Luk13g/Absolute_Encoder_5Bits/Imagens/Img_03.jpg

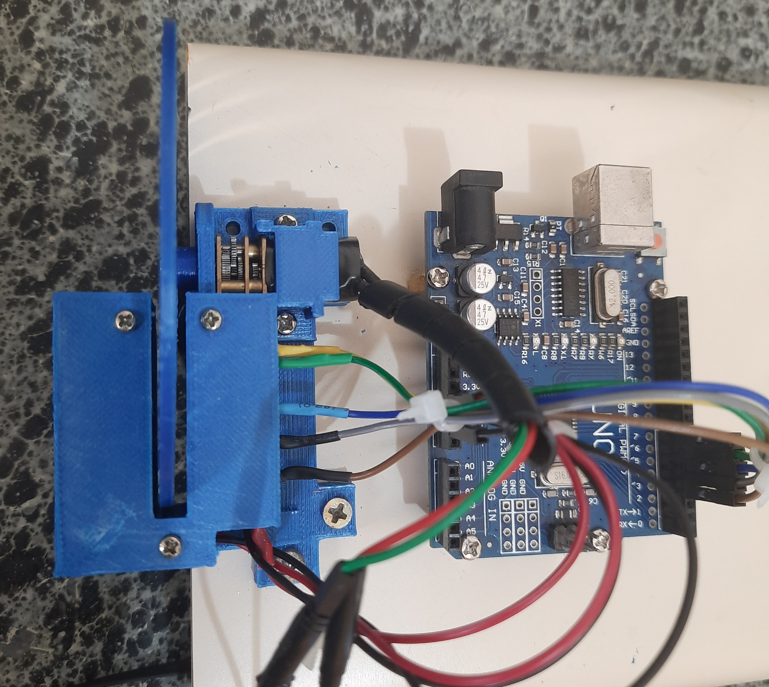
Imagens/Img_03.jpg
