Luk13g/Absolute_Encoder_5Bits/Imagens/Img_02.jpg

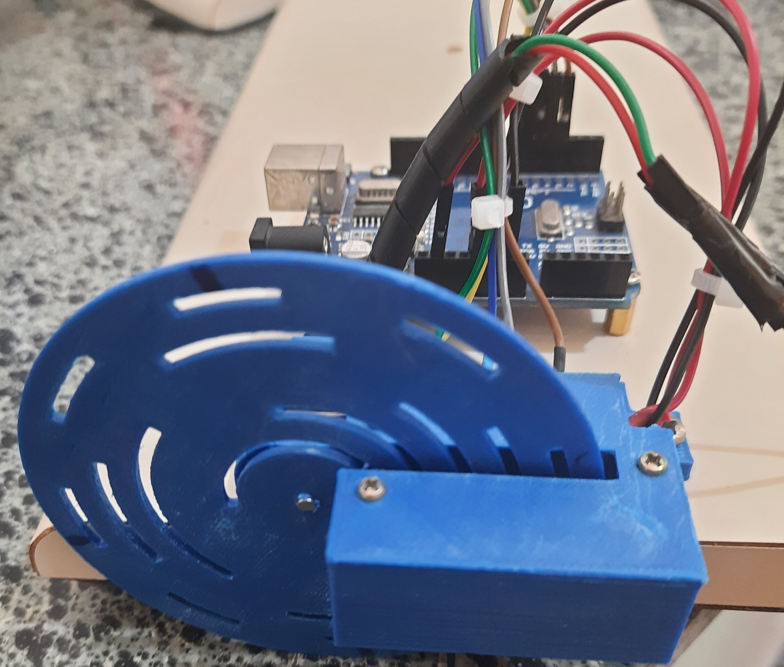
Imagens/Img_02.jpg
