Luk13g/Absolute_Encoder_5Bits/README.md

# Absolute_Encoder_5Bits
Absolute rotary encoder with 5 rows of slits
