Luk13g/Absolute_Encoder_5Bits/Imagens/Img_01.jpg

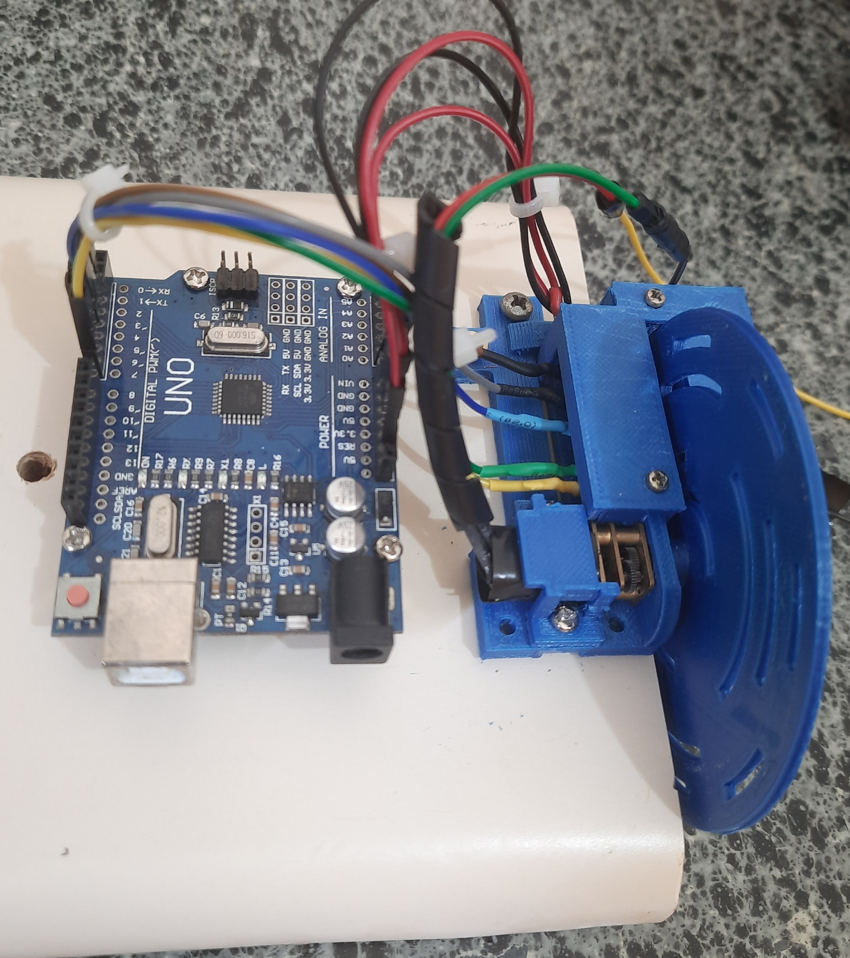
Imagens/Img_01.jpg
