Luk13g/Absolute_Encoder_5Bits/3D_parts/disco_oficial_code_gray.stl

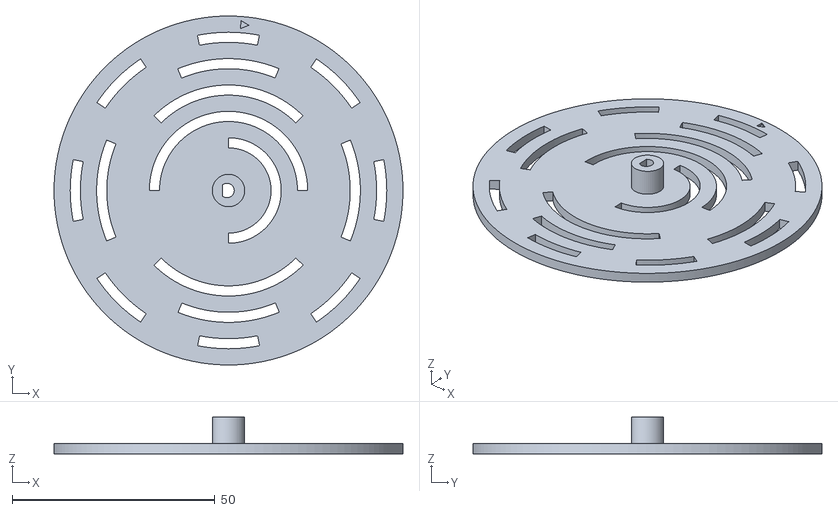
[picture p4: CAD file, 2022-12-28]
3D_parts/disco_oficial_code_gray.stl
86.0 x 86.0 x 9.00
