Luk13g/Absolute_Encoder_5Bits/3D_parts/TESTEE.stl

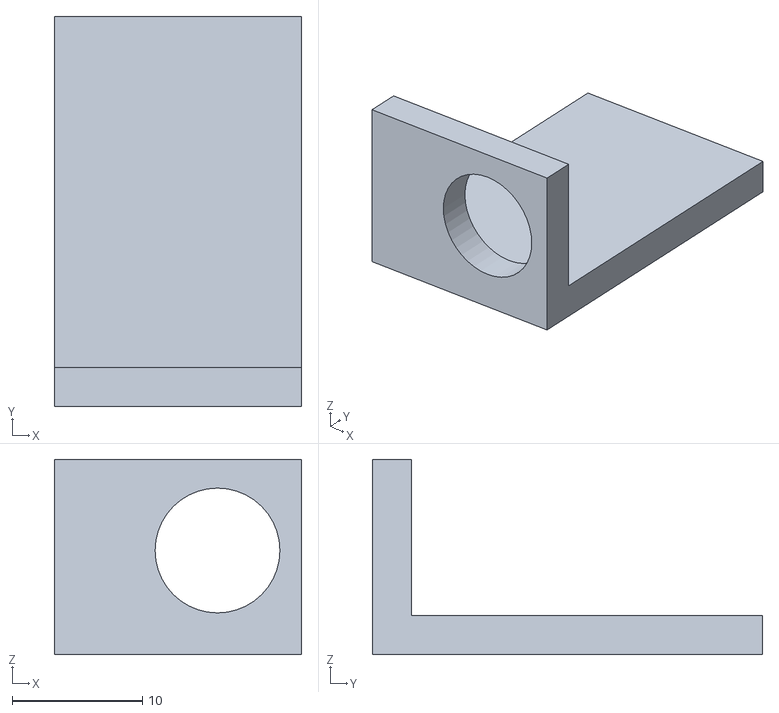
[picture p5: CAD file, 2022-12-28]
3D_parts/TESTEE.stl
19.0 x 30.0 x 15.0
