Luk13g/Absolute_Encoder_5Bits/3D_parts/suporte_sensores2.stl

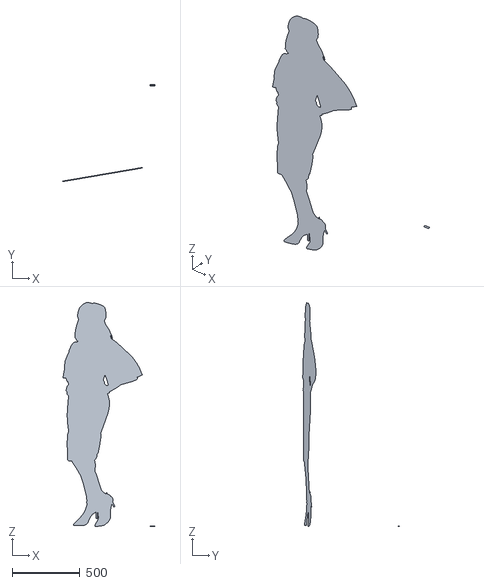
[picture p6: CAD file, 2022-12-28]
3D_parts/suporte_sensores2.stl
680.1 x 712.3 x 1649.7
