Luk13g/Absolute_Encoder_5Bits/3D_parts/4_teste_pecas.stl

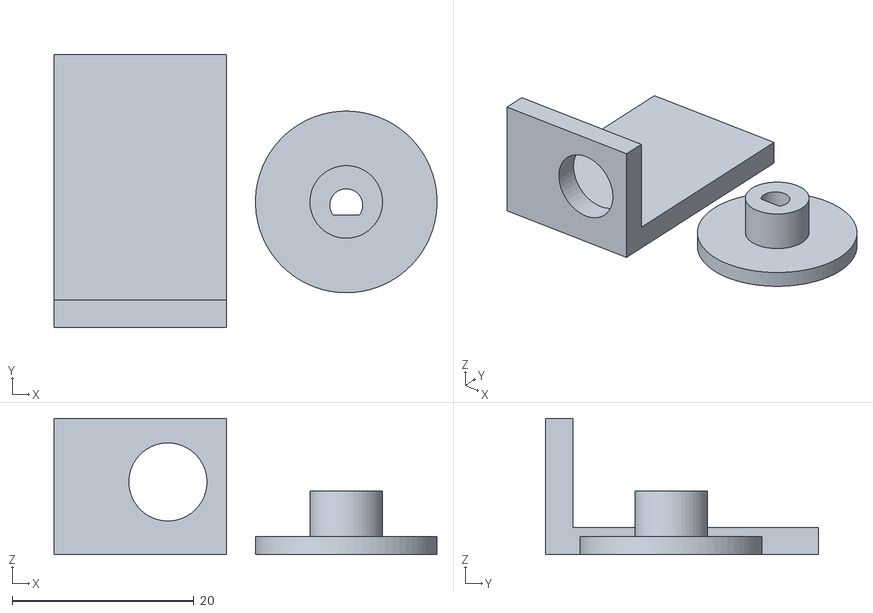
[picture p7: CAD file, 2022-12-28]
3D_parts/4_teste_pecas.stl
42.2 x 30.0 x 15.0
