Luk13g/Absolute_Encoder_5Bits/3D_parts/suporte_motor_oficial2.stl

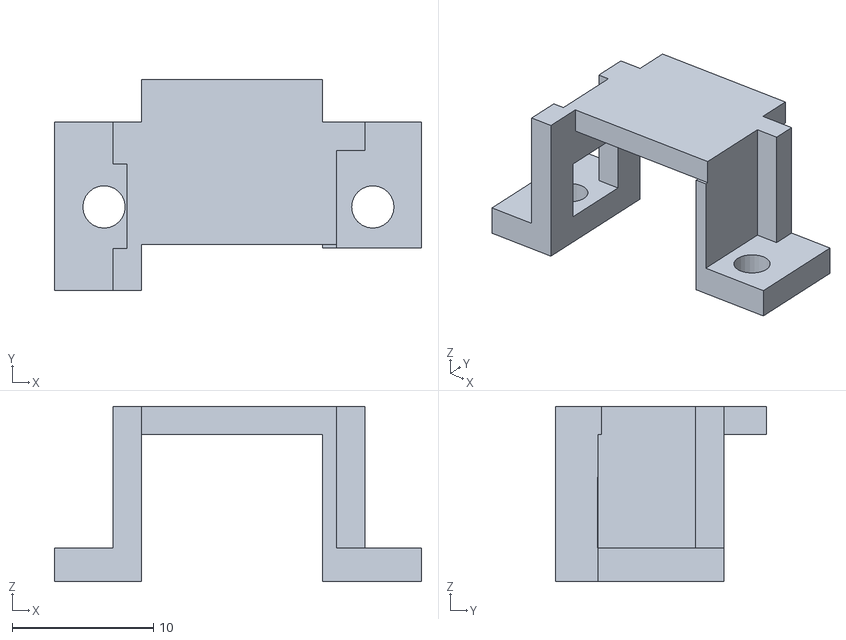
[picture p8: CAD file, 2022-12-28]
3D_parts/suporte_motor_oficial2.stl
25.9 x 14.9 x 12.4
