Luk13g/Absolute_Encoder_5Bits/3D_parts/disco_oficial.stl

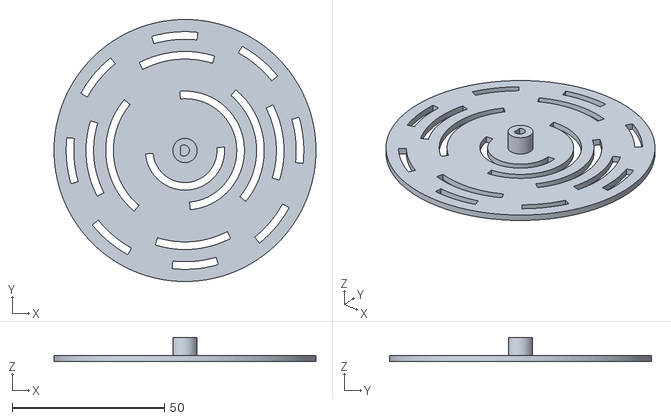
[picture p9: CAD file, 2022-12-28]
3D_parts/disco_oficial.stl
86.0 x 86.0 x 8.00
