Luk13g/Absolute_Encoder_5Bits/3D_parts/suporte_sensores.stl

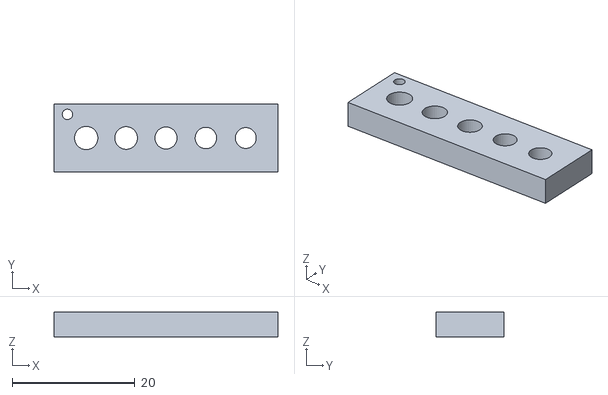
[picture p10: CAD file, 2022-12-28]
3D_parts/suporte_sensores.stl
36.5 x 11.0 x 4.00
