Luk13g/Absolute_Encoder_5Bits/3D_parts/suporte_motor_oficial.stl

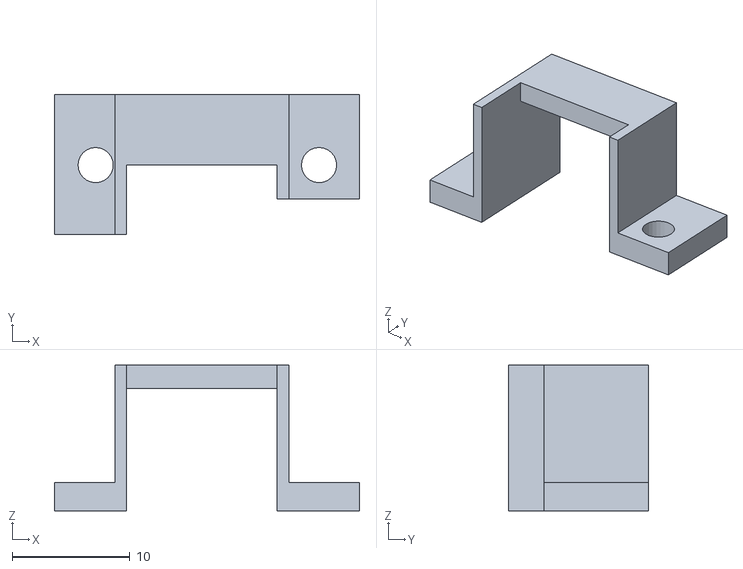
[picture p12: CAD file, 2022-12-28]
3D_parts/suporte_motor_oficial.stl
25.9 x 11.9 x 12.4
