Luk13g/Absolute_Encoder_5Bits/3D_parts/protecao_sensores_oficial.stl

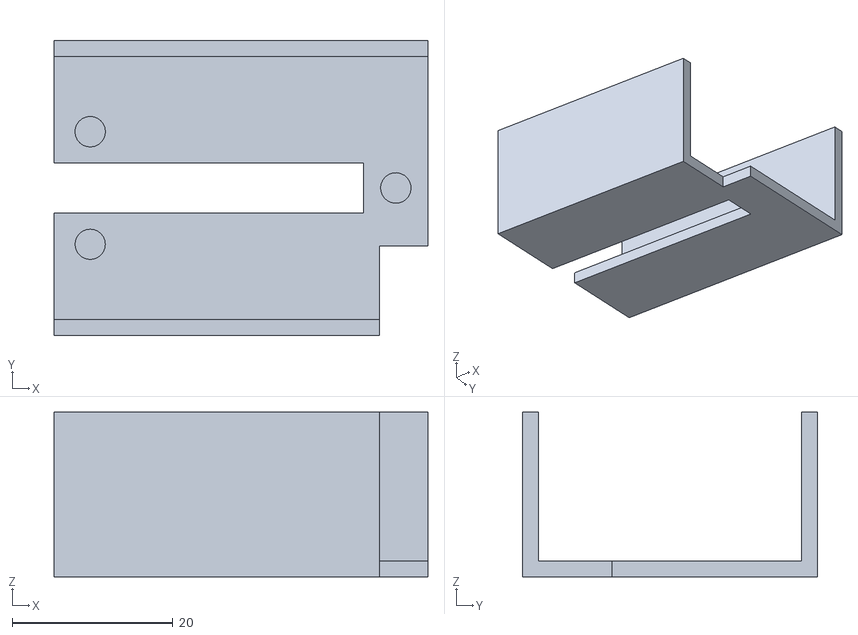
[picture p13: CAD file, 2022-12-28]
3D_parts/protecao_sensores_oficial.stl
46.5 x 36.7 x 20.5
