Luk13g/Absolute_Encoder_5Bits/3D_parts/eixo_motor.stl

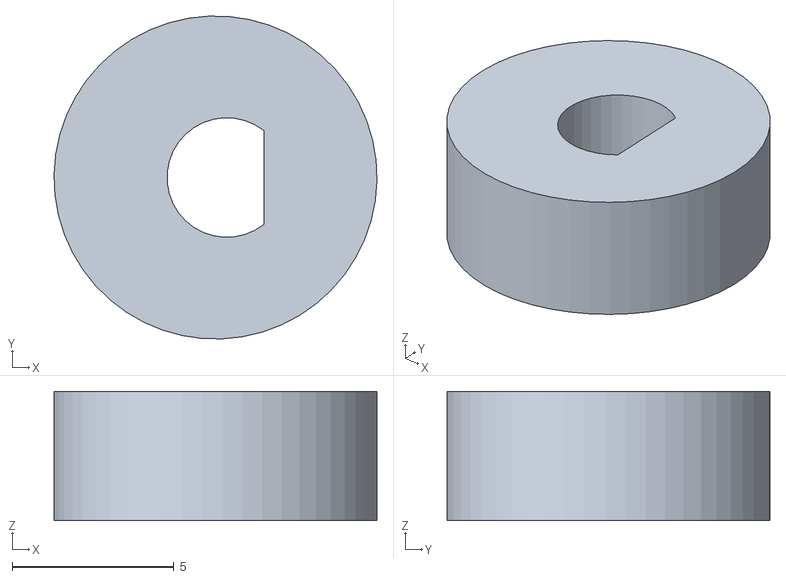
[picture p14: CAD file, 2022-12-28]
3D_parts/eixo_motor.stl
10.00 x 9.99 x 4.00
