Luk13g/Absolute_Encoder_5Bits/3D_parts/disco_encoder_2.stl

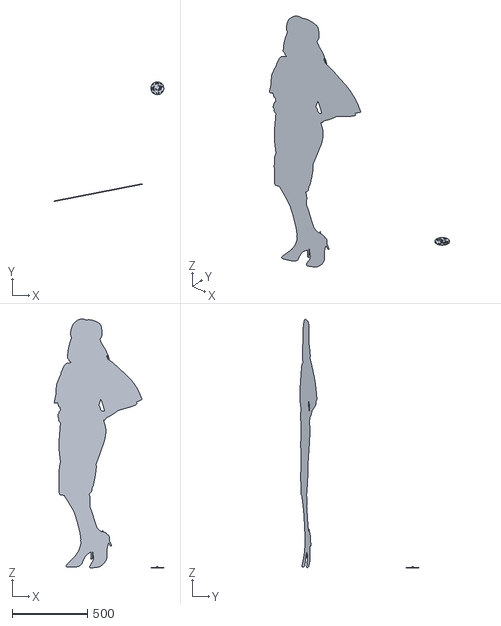
[picture p15: CAD file, 2022-12-28]
3D_parts/disco_encoder_2.stl
726.5 x 791.3 x 1649.7
