Luk13g/Absolute_Encoder_5Bits/3D_parts/TESTE_SUPORTE_LEDS.stl

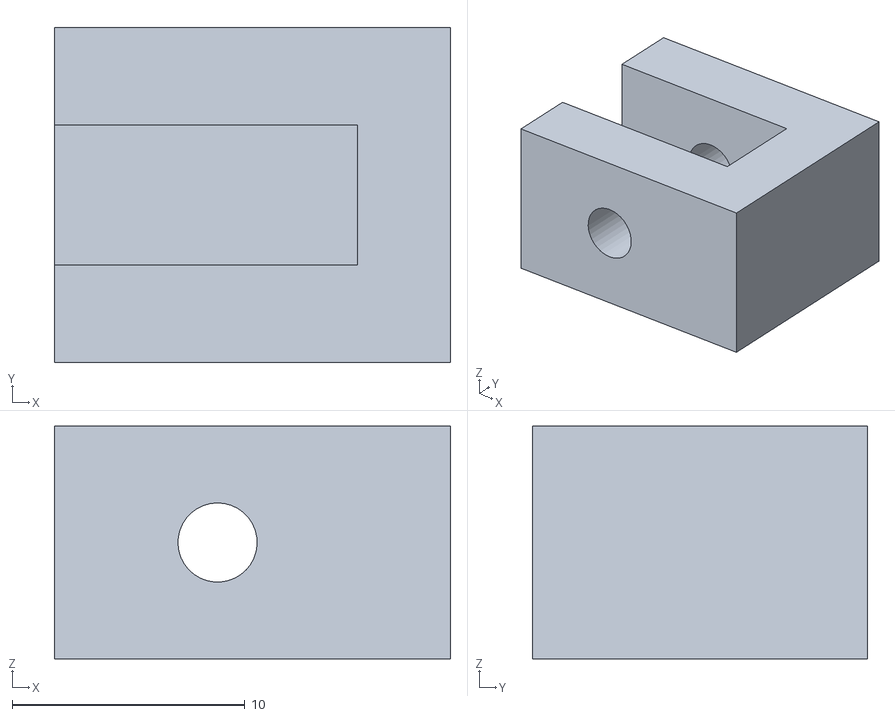
[picture p16: CAD file, 2022-12-28]
3D_parts/TESTE_SUPORTE_LEDS.stl
17.0 x 14.4 x 10.0
