Luk13g/Absolute_Encoder_5Bits/3D_parts/eixo_motor2.stl

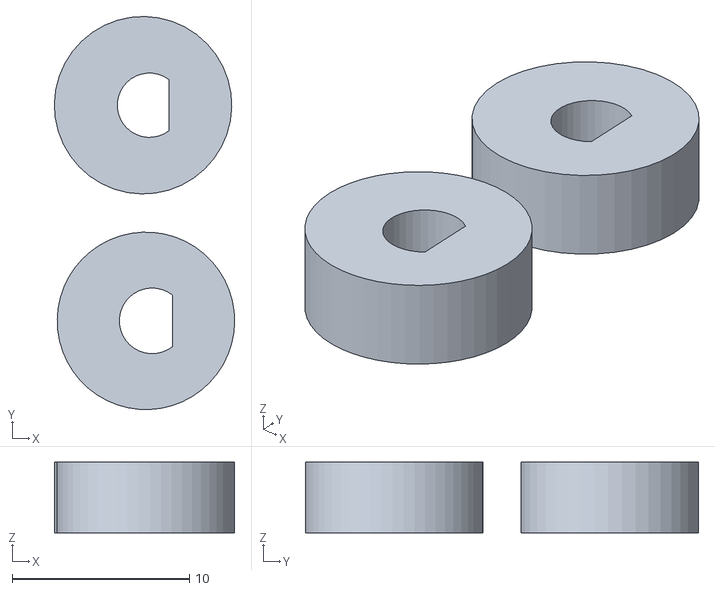
[picture p17: CAD file, 2022-12-28]
3D_parts/eixo_motor2.stl
10.2 x 22.1 x 4.00
