Luk13g/Absolute_Encoder_5Bits/3D_parts/PECA_SUPORTE_OFICIAL.stl

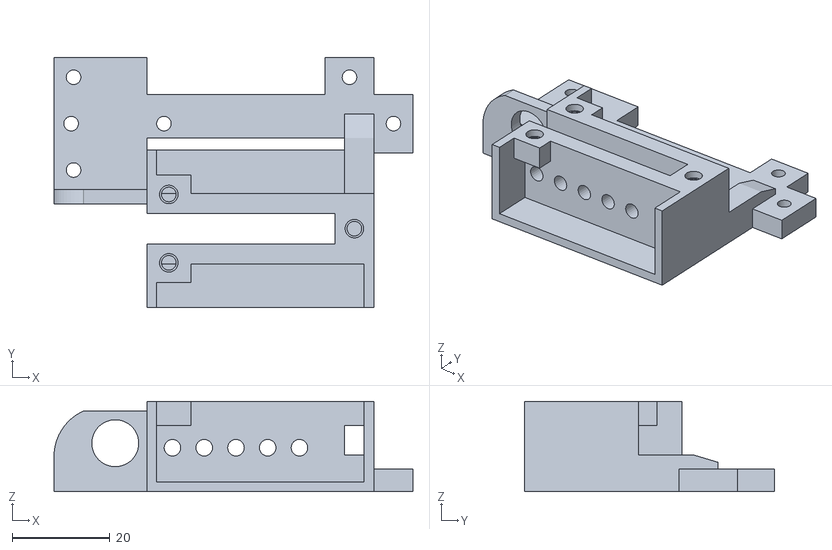
[picture p18: CAD file, 2022-12-28]
3D_parts/PECA_SUPORTE_OFICIAL.stl
73.5 x 51.1 x 18.5
