Luk13g/Absolute_Encoder_5Bits/(list of files, cad)

Other CAD files:
3D_parts/TESTEE2.stl
3D_parts/PECA_SUPORTE_OFICIAL.skp
3D_parts/TESTEE.skp
3D_parts/TESTE_SUPORTE_LEDS.skp
3D_parts/disco_encoder_2.skp
3D_parts/disco_encoder_abs.skp
3D_parts/disco_modelo_base.skp
3D_parts/disco_oficial_code_gray.skp
3D_parts/eixo_motor.skp
3D_parts/encoder_completo.skp
3D_parts/protecao_sensores_oficial.skp
3D_parts/protecao_sensores_oficial2.skp
3D_parts/suporte_motor_oficial.skp
3D_parts/suporte_motor_oficial2.skp
3D_parts/suporte_sensores.skp
