Luk13g/Absolute_Encoder_5Bits/Codes/Arduino/5bit_abs_encoder.ino

boolean pin_state[10];
byte input_pin[] = {3,4,5,6,7}; // Config Pins Input Here bit-1 to 5
int dec_position = 0;

boolean a = 0;
void setup() {

Serial.begin(9600);

for(byte i = 0; i <5; i = i +1 ){ // declare pin mode
  pinMode(input_pin[i], INPUT);
}

}

void loop() {
 Read_input(); // Read Encoder Signal
 delay(100);
 
}

void Read_input(){
  for(byte i = 0; i <5; i = i + 1 ){
    pin_state[i] = digitalRead(input_pin[i]); 
  }
  
  // Gray Code Decoder
  dec_position = pin_state[4];
  for( int i = 3; i >= 0; i = i -1){
    dec_position = (dec_position << 1) | (pin_state[i] ^ (dec_position&0x1));
  }
  
  // Print 0-1023 position with line feed
  //Serial.print("RAW position: "); 
  Serial.println(dec_position, DEC); 
  //Serial.print("Position in degree: "); 
 // Serial.print(dec_position * 11.25);
  //Serial.println("°");
}
