Luk13g/Absolute_Encoder_5Bits/(commit log)

2022-12-28 codes absolute encoder
2022-12-28 hardware sensors encoder
    [sensores.kicad_pcb, sensores.sch]
2022-12-28 3D parts absolute encoder (stl/sketchup)
    [4_teste_pecas.stl, PECA_SUPORTE_OFICIAL.skp, PECA_SUPORTE_OFICIAL.stl, TESTEE.skp, TESTEE.stl, TESTEE2.stl, TESTE_SUPORTE_LEDS.skp, TESTE_SUPORTE_LEDS.stl]
2022-12-28 ready absolute encoder images
